Diaosi1111/FlightFCU/Core/Inc/main.h

#define APPR_LED_Pin        GPIO_PIN_13
#define APPR_LED_GPIO_Port  GPIOC
#define COL_4_Pin           GPIO_PIN_14
#define COL_4_GPIO_Port     GPIOC
#define ROW_3_Pin           GPIO_PIN_15
#define ROW_3_GPIO_Port     GPIOC
#define LOC_LED_Pin         GPIO_PIN_0
#define LOC_LED_GPIO_Port   GPIOA
#define ALT_B_Pin           GPIO_PIN_1
#define ALT_B_GPIO_Port     GPIOA
#define ALT_A_Pin           GPIO_PIN_2
#define ALT_A_GPIO_Port     GPIOA
#define ALT_A_EXTI_IRQn     EXTI2_IRQn
#define HDG_B_Pin           GPIO_PIN_3
#define HDG_B_GPIO_Port     GPIOA
#define HDG_A_Pin           GPIO_PIN_4
#define HDG_A_GPIO_Port     GPIOA
#define HDG_A_EXTI_IRQn     EXTI4_IRQn
#define SPD_B_Pin           GPIO_PIN_5
#define SPD_B_GPIO_Port     GPIOA
#define SPD_A_Pin           GPIO_PIN_6
#define SPD_A_GPIO_Port     GPIOA
#define SPD_A_EXTI_IRQn     EXTI9_5_IRQn
#define EXPED_LED_Pin       GPIO_PIN_7
#define EXPED_LED_GPIO_Port GPIOA
#define AP2_LED_Pin         GPIO_PIN_0
#define AP2_LED_GPIO_Port   GPIOB
#define ATHR_LED_Pin        GPIO_PIN_1
#define ATHR_LED_GPIO_Port  GPIOB
#define AP1_LED_Pin         GPIO_PIN_12
#define AP1_LED_GPIO_Port   GPIOB
#define COL_2_Pin           GPIO_PIN_13
#define COL_2_GPIO_Port     GPIOB
#define ROW_1_Pin           GPIO_PIN_14
#define ROW_1_GPIO_Port     GPIOB
#define COL_1_Pin           GPIO_PIN_15
#define COL_1_GPIO_Port     GPIOB
#define SPD_MACH_Pin        GPIO_PIN_8
#define SPD_MACH_GPIO_Port  GPIOA
#define ROW_2_Pin           GPIO_PIN_4
#define ROW_2_GPIO_Port     GPIOB
#define COL_3_Pin           GPIO_PIN_5
#define COL_3_GPIO_Port     GPIOB
#define VS_B_Pin            GPIO_PIN_8
#define VS_B_GPIO_Port      GPIOB
#define VS_A_Pin            GPIO_PIN_9
#define VS_A_GPIO_Port      GPIOB
#define VS_A_EXTI_IRQn      EXTI9_5_IRQn
