Diaosi1111/FlightFCU/Core/Inc/stm32_u8g2.h

#ifndef __STM32_U8G2_H
#define __STM32_U8G2_H

/* Includes ------------------------------------------------------------------*/
#include "main.h"
#include "u8g2.h"
/* USER CODE BEGIN Prototypes */
uint8_t u8x8_byte_hw_i2c1(__attribute__((unused)) u8x8_t *u8x8, uint8_t msg, uint8_t arg_int, void *arg_ptr);
uint8_t u8x8_byte_hw_i2c2(__attribute__((unused)) u8x8_t *u8x8, uint8_t msg, uint8_t arg_int, void *arg_ptr);
uint8_t u8x8_gpio_and_delay(u8x8_t *u8x8, uint8_t msg, uint8_t arg_int, void *arg_ptr);
void u8g2_init_hi2c1(u8g2_t *u8g2);
void u8g2_init_hi2c2(u8g2_t *u8g2);
void draw(u8g2_t *u8g2);
void testDrawPixelToFillScreen(u8g2_t *u8g2);

#endif
