Diaosi1111/FlightFCU/(commit log)

2023-05-26 HAL USB 注意上拉电阻
2023-05-26 功能基本完善
2023-06-02 fix: fpa value print error
    [main.c]
2023-06-02 fix:long push metric button for alt increment pace toggle
    [main.h]
